kpointerPDX/ECE411-G9/README.md

# ECE411-G9
Public repository for ECE-411 Group 9 @ PSU, 2022.

Gantt Chart for project tracking: https://sharing.clickup.com/42085151/g/h/184arz-80/8154f2cd82b7851
