kpointerPDX/ECE411-G9/ECE411BOM.xlsx

Bill Of Materials for: [Group9] [Mustafa Alazzaw, Kyle Pointer, Brandon Hippe, Te Yan]
Last modified: [11/9/22]
PCB version: [PCB VERSION #]
BOM revision: [BOM REVISION #] |  | P/NP | = Place/Not Place (components marked NP are not stuffed on the board)
Cnt | Part References | P/NP | Mfg | Mfg PN | Description | Dist | Dist Part Number | Cost Ea. | Cost Total
1 | J1 | P | ‎Sonew | ‎Sonewfxb8vt90mg | DC 12V Electronic Door Lock Solenoid | Amazon | B07H4G4K7R | $15.19 | $15.19
1 | J2 | P | ‎DollaTek | 1528-4690-ND | DollaTek Blue Light Optical Fingerprint Reader Sensor Module for Mega2560 R3 | Amazon | B07PRMXXXN | $21.99 | $21.99
1 | U2 | P | HiLetgo | 3-01-0045 | HiLetgo 2pcs HD44780 1602 LCD Display Module DC 5V 16x2 Character LCM Blue Blacklight New | Amazon | B00HJ6AFW6 | $8.99 | $8.99
1 | A1 | P | ELEGOO | EL-CB-001 | ELEGOO UNO R3 Board ATmega328P | Amazon | B01EWOE0UU | $17.99 | $17.99
1 | J3 | P | Aediko | N/A | AEDIKO 4pcs Relay Module DC 12V Relay Board | Amazon | 14921 | $7.82 | $7.82
4 | SW1, SW2, SW3, SW4 | P | QTEATAK | N/A | button switch | Amazon | JF0022 | $5.99 | $5.99
4 | R1, R2, R3, R4 | P | EDGELEC | EFR-W0D50-A:MF | 1K resistor | Amazon | [E5P004] 1K ohm / 0.5w / ±1% | $5.99 | $5.99
 |  |  |  |  |  |  |  | Total | $83.96
