kpointerPDX/ECE411-G9/F360/LockChassisPlate_v1_4.stl

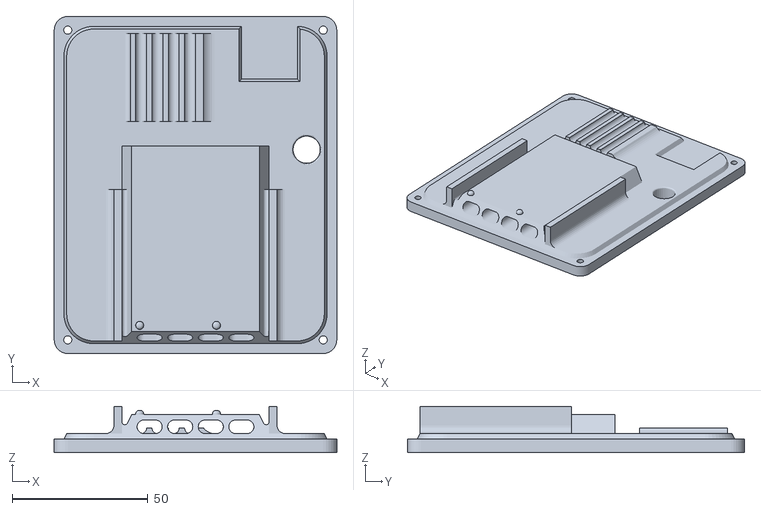
[picture p7: CAD file, 2022-12-08]
F360/LockChassisPlate_v1_4.stl
104.0 x 124.0 x 17.0
