kpointerPDX/ECE411-G9/F360/LockChassisCover_v1_3.stl

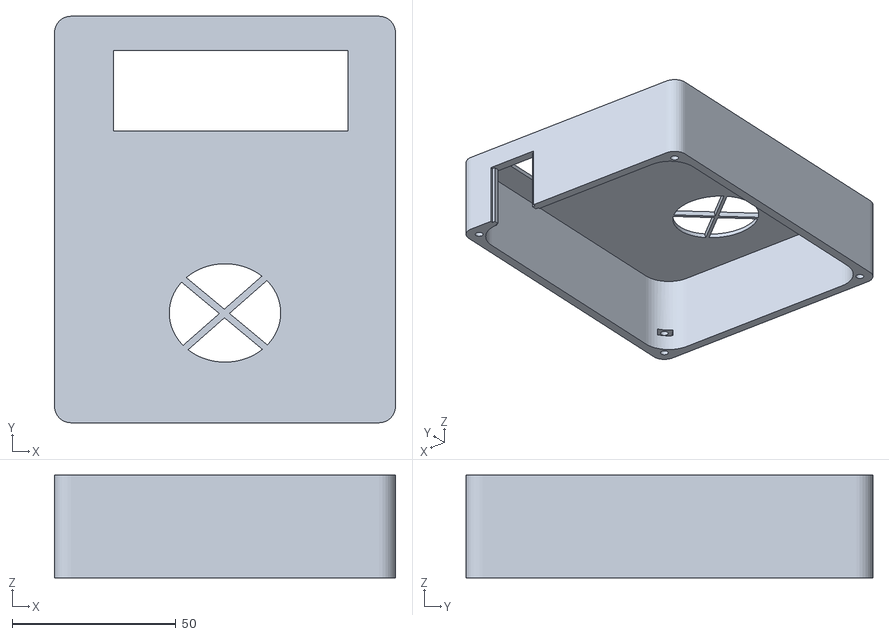
[picture p8: CAD file, 2022-12-08]
F360/LockChassisCover_v1_3.stl
104.0 x 124.0 x 31.4
