kpointerPDX/ECE411-G9/F360/LockChassisButton_v1_3.stl

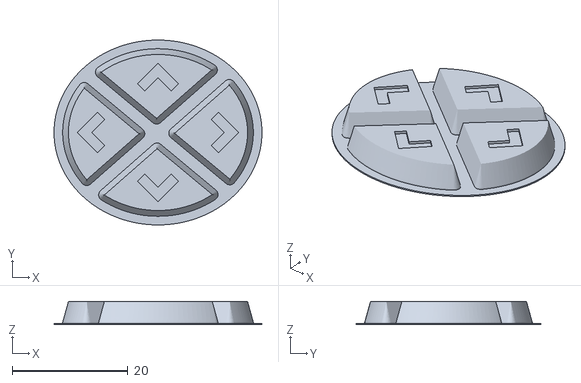
[picture p9: CAD file, 2022-12-08]
F360/LockChassisButton_v1_3.stl
36.0 x 32.0 x 4.00
