kpointerPDX/ECE411-G9/(list of files, cad)

Other CAD files:
F360/LockChassis v14.f3d
