kpointerPDX/ECE411-G9/ECE411-Group9_OverviewSchematic.pdf

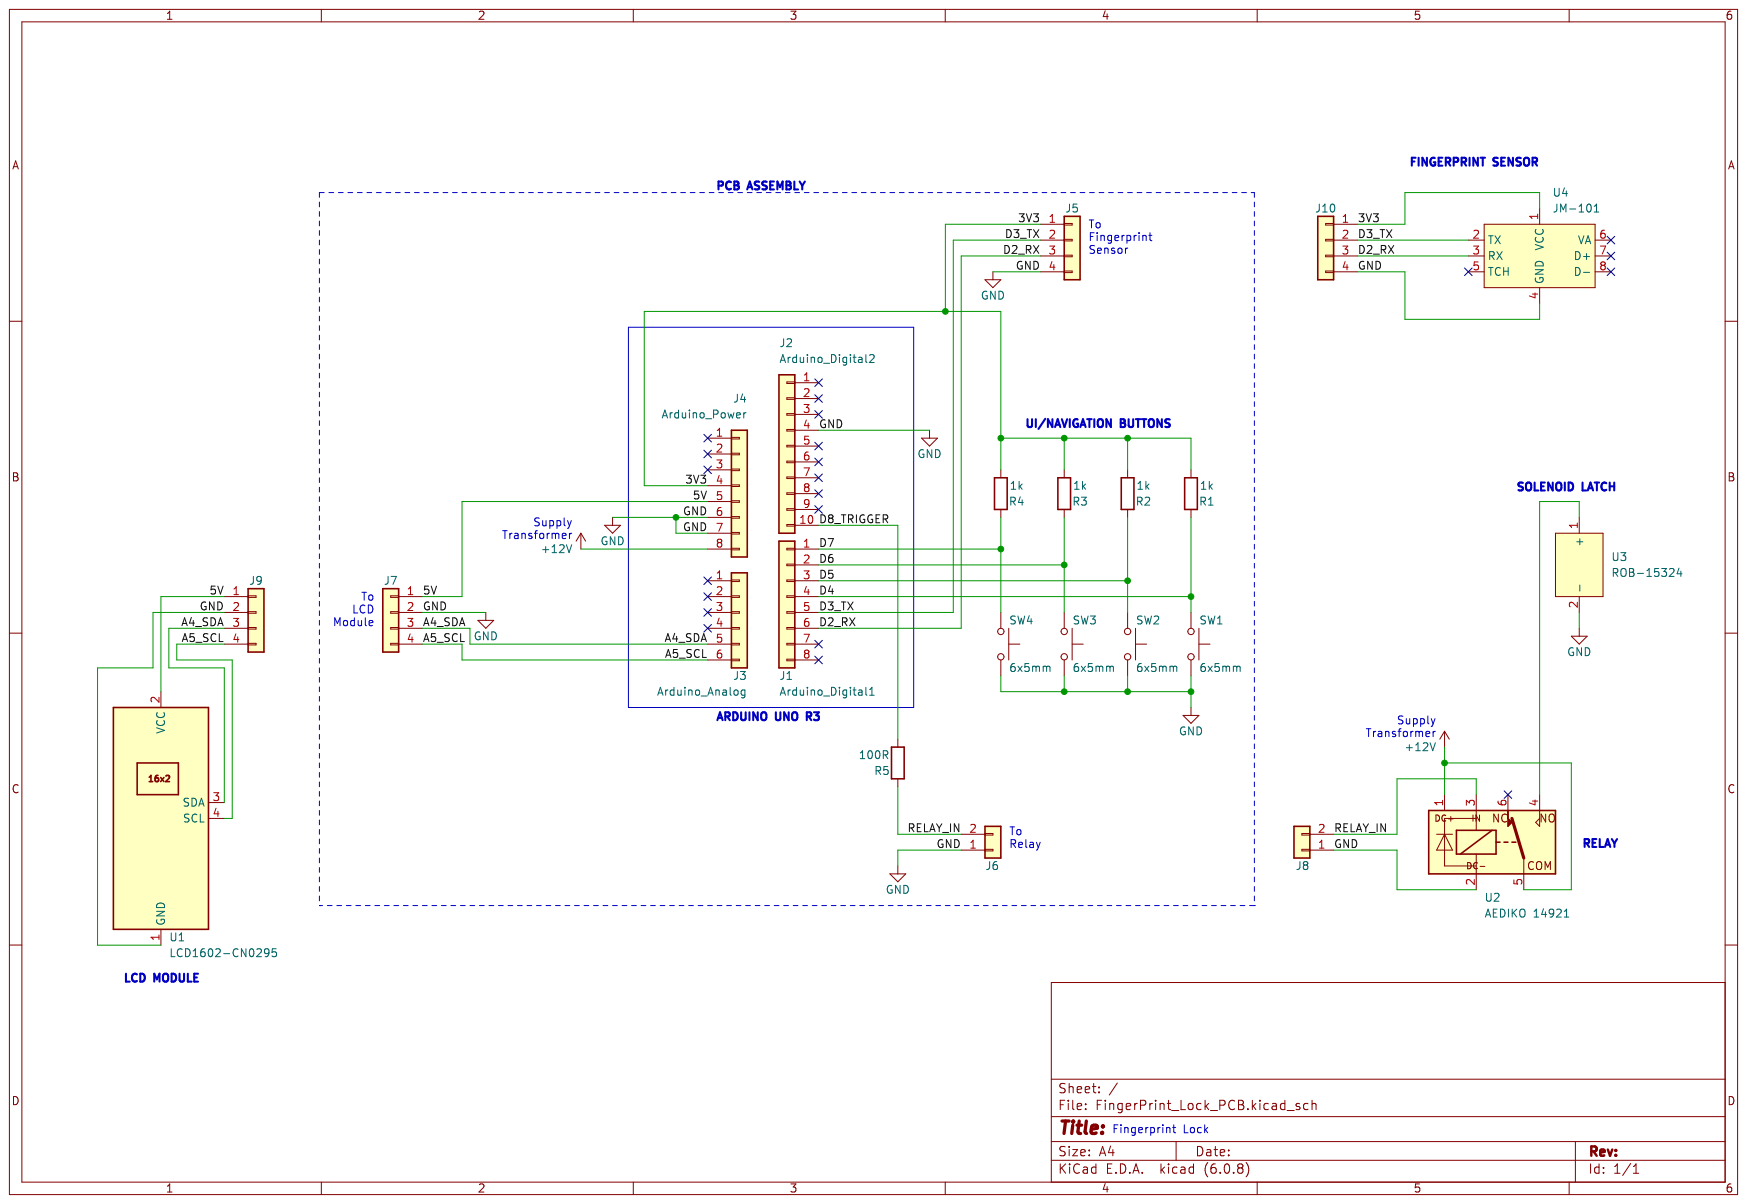
[picture p10: page 1]
