kpointerPDX/ECE411-G9/FingerPrint_Lock_PCB.kicad_pcb

## KiCad design FingerPrint_Lock_PCB.kicad_pcb (2022-11-16)

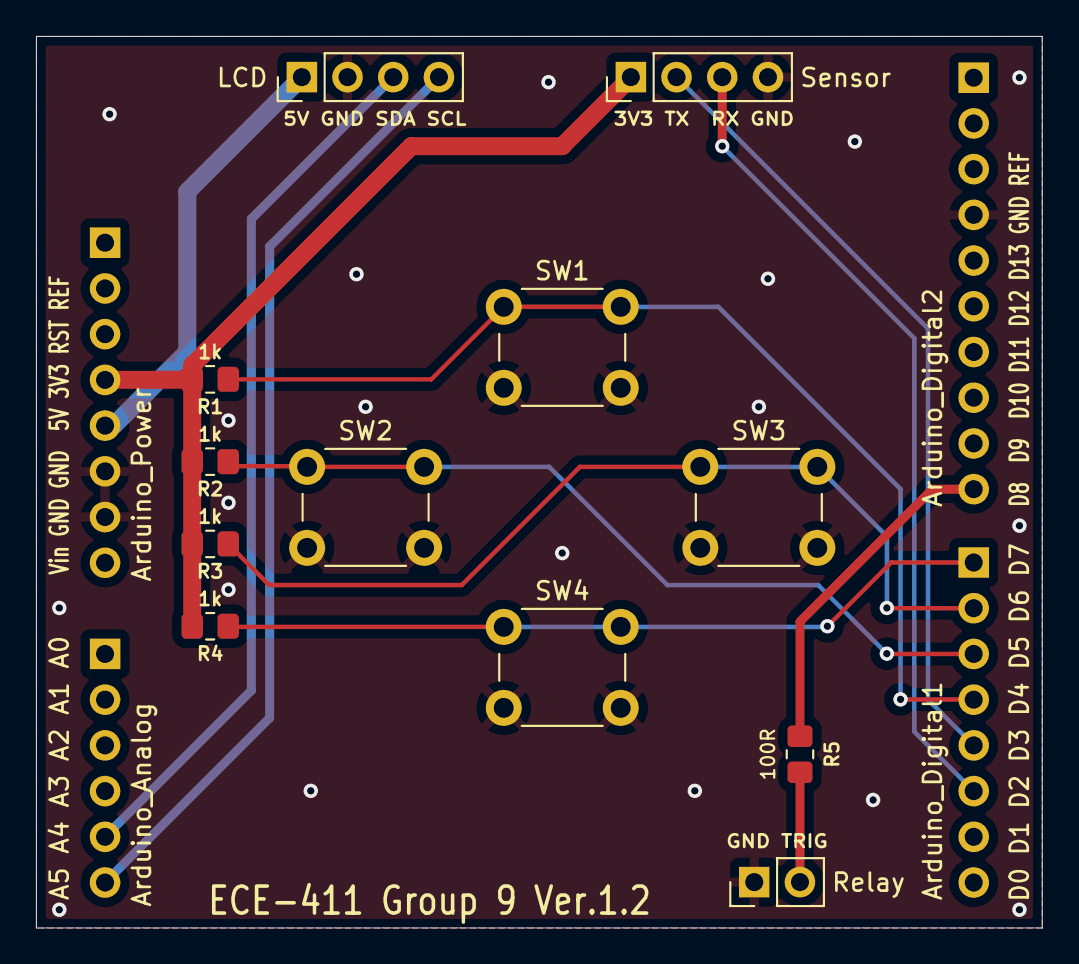
[picture p11: board FingerPrint_Lock_PCB.kicad_pcb from above]

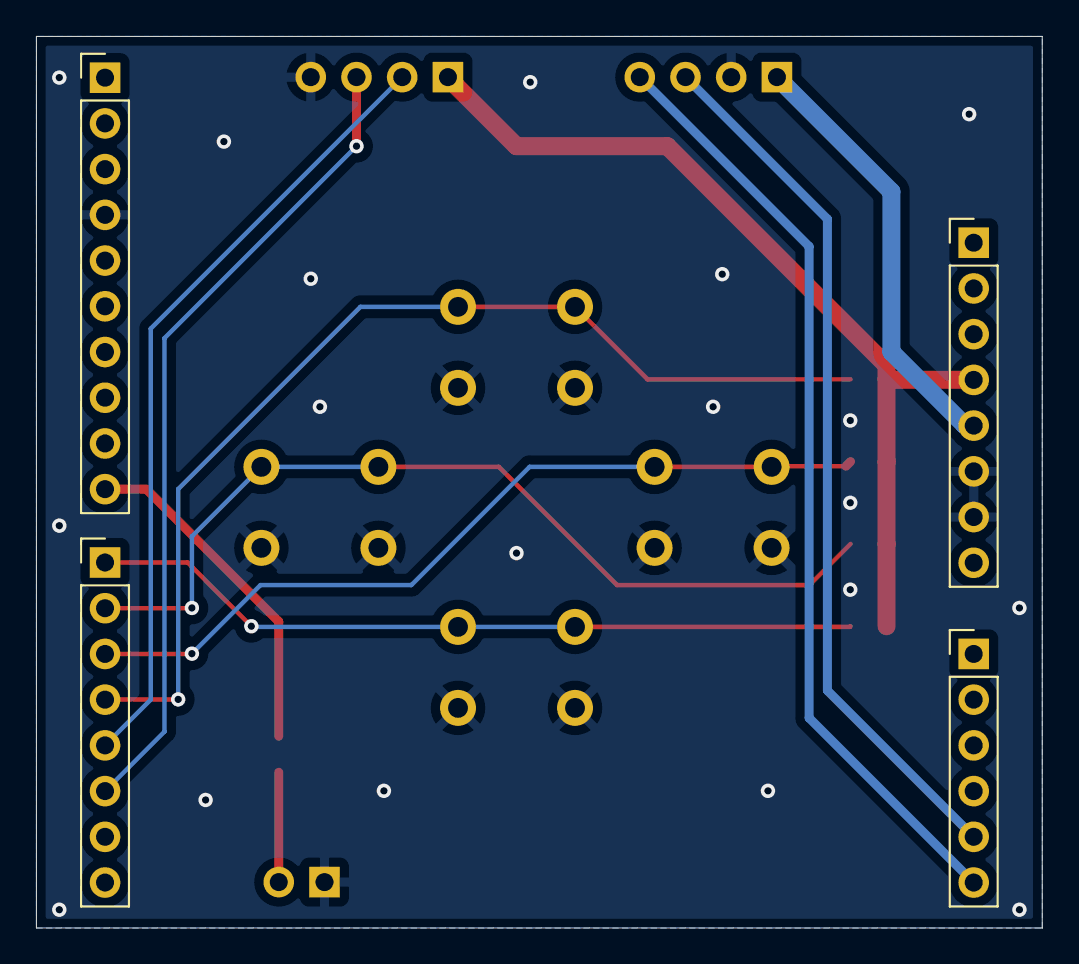
[picture p12: board FingerPrint_Lock_PCB.kicad_pcb from below]

Board: 2 copper layers, 55.9 x 49.5 mm, 16 parts (4 on the bottom side), 13 nets.

Parts:
J1: Arduino_Digital1; PinHeader_1x08_P2.54mm_Vertical
J2: Arduino_Digital2; PinHeader_1x10_P2.54mm_Vertical
J3: Arduino_Analog; PinHeader_1x06_P2.54mm_Vertical
J4: Arduino_Power; PinHeader_1x08_P2.54mm_Vertical
J5: Sensor; PinHeader_1x04_P2.54mm_Vertical
J6: Relay; PinHeader_1x02_P2.54mm_Vertical
J7: LCD; PinHeader_1x04_P2.54mm_Vertical
R1, R2, R3, R4: 1k; R_0805_2012Metric_Pad1.20x1.40mm_HandSolder
R5: 100R; R_0805_2012Metric_Pad1.20x1.40mm_HandSolder
SW1, SW2, SW3, SW4: 6x5mm; SW_PUSH_6mm_H5mm

Connections:
/3V3: J4.4, J5.1, R1.2, R2.2, R3.2, R4.2
/5V: J4.5, J7.1
/A4_SDA: J3.5, J7.3
/A5_SCL: J3.6, J7.4
/D2_RX: J1.6, J5.3
/D3_TX: J1.5, J5.2
/D4: J1.4, R1.1, SW1.1
/D5: J1.3, R2.1, SW2.1
/D6: J1.2, R3.1, SW3.1
/D7: J1.1, R4.1, SW4.1
/D8_TRIGGER: J2.10, R5.2
/RELAY_IN: J6.2, R5.1
GND: J2.4, J4.6, J4.7, J5.4, J6.1, J7.2, SW1.2, SW2.2, SW3.2, SW4.2
