kpointerPDX/ECE411-G9/(commit log)

2022-10-27 initial upload
    [FingerPrint Lock.kicad_sch]
2022-10-27 mistaken upload
    [FingerPrint Lock.kicad_sch]
2022-10-27 name correction
    [FingerPrint_Lock.kicad_sch]
2022-11-10 Add files via upload
    Functional decomposition of device and components.
2022-11-10 Add files via upload
    Corrected connections and labels. Added 4th button.
    [FingerPrint_Lock.kicad_sch]
2022-11-14 Final(?) schematics/PCB upload
    Final(?) version of overview schematic, PCB file, and PCB Schematic.
    [FingerPrint_Lock.kicad_sch, FingerPrint_Lock_PCB.kicad_pcb, FingerPrint_Lock_PCB.kicad_sch]
2022-11-15 Post-design-review revisions
    [FingerPrint_Lock_PCB.kicad_pcb, FingerPrint_Lock_PCB.kicad_sch]
2022-11-15 Schematic files unified; original now deprecated
    [FingerPrint_Lock.kicad_sch]
2022-11-16 Minor changes; updated silkscreen
    [FingerPrint_Lock_PCB.kicad_pcb, FingerPrint_Lock_PCB.kicad_sch]
2022-11-22 Create Interface.ino
    Initial Button/LCD User interface.
2022-12-01 Initial upload: PDF version of overall schematic
2022-12-08 Added 3d model files for chassis
    [LockChassis v14.f3d, LockChassisButton_v1_3.stl, LockChassisCover_v1_3.stl, LockChassisPlate_v1_4.stl]
